iank/frogsboro/README.md

# frogsboro
FROGSBORO SAM9X60 board

Assembled board
Layout
