iank/frogsboro/(list of files, cad)

Other CAD files:
exports/frogsboro_v1.0.2/FROGSBORO.step
