iank/frogsboro/exports/frogsboro_v1.0.2/frogsboro_bom_v1.0.2.pdf

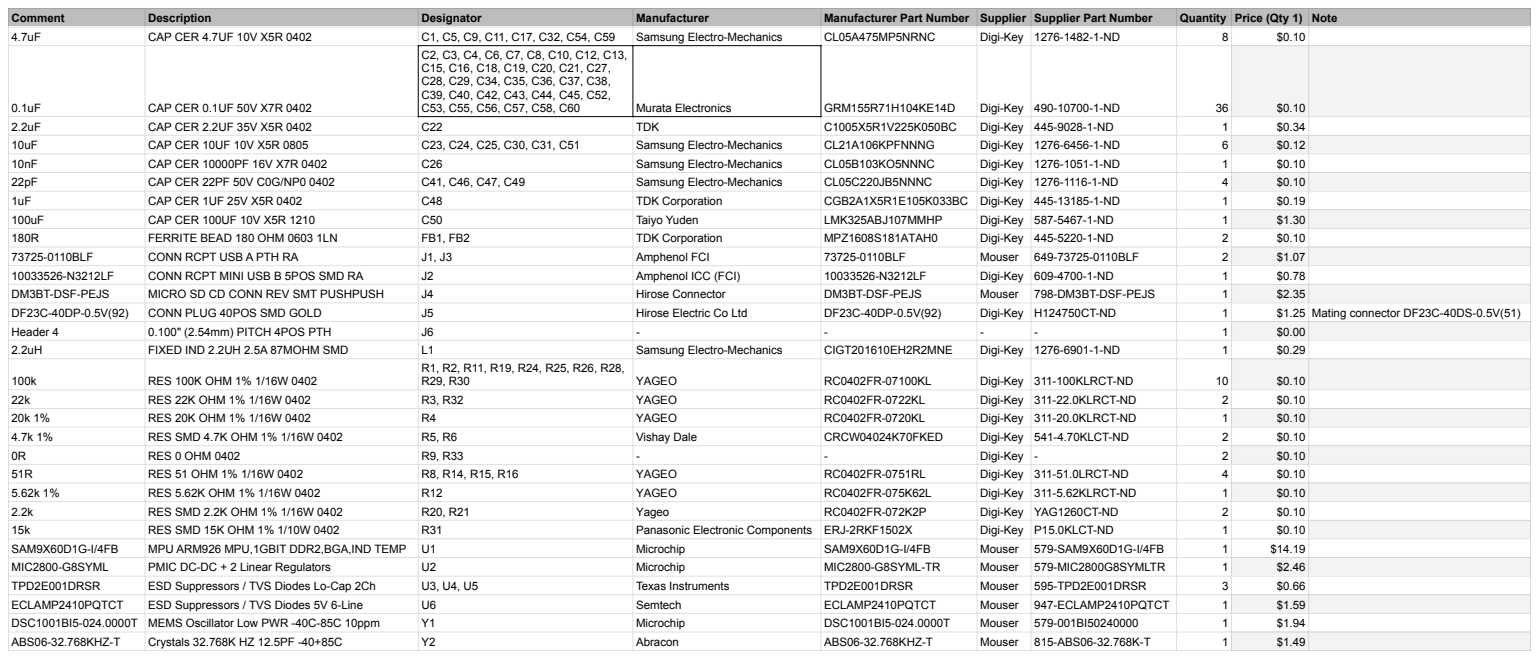
[picture p1: page 1]
