iank/frogsboro/exports/frogsboro_v1.0.2/frogsboro_schematic_v1.0.2.pdf

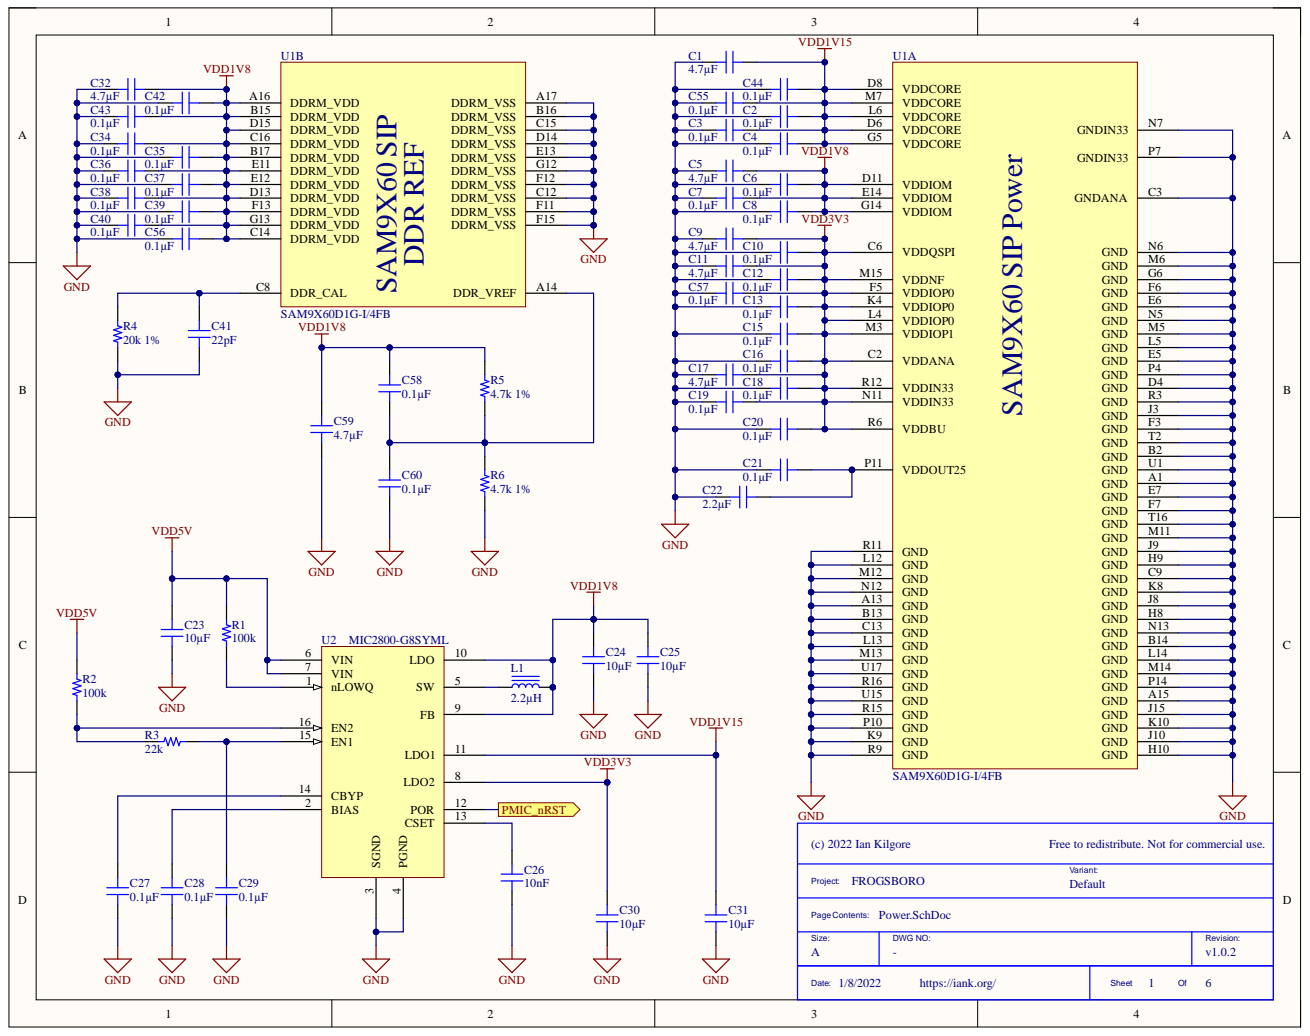
[picture p2: page 1]

4. 7 | µ F | C10
C1 1 | 0. 1 | µ F | M15 | M 6

C57 | 0. 1 | µ F | F 5 | F 6
0. 1 µ F | C13 | | K 4 | E 6

C19 | 0. 1 µ F
0. 1 | | J 3

Si z e : A | DWG NO : - | Re v i s i o n : v1.0.

Date : 1/8/2022 ht tps : //i ank.org/ | Sh e e t O f

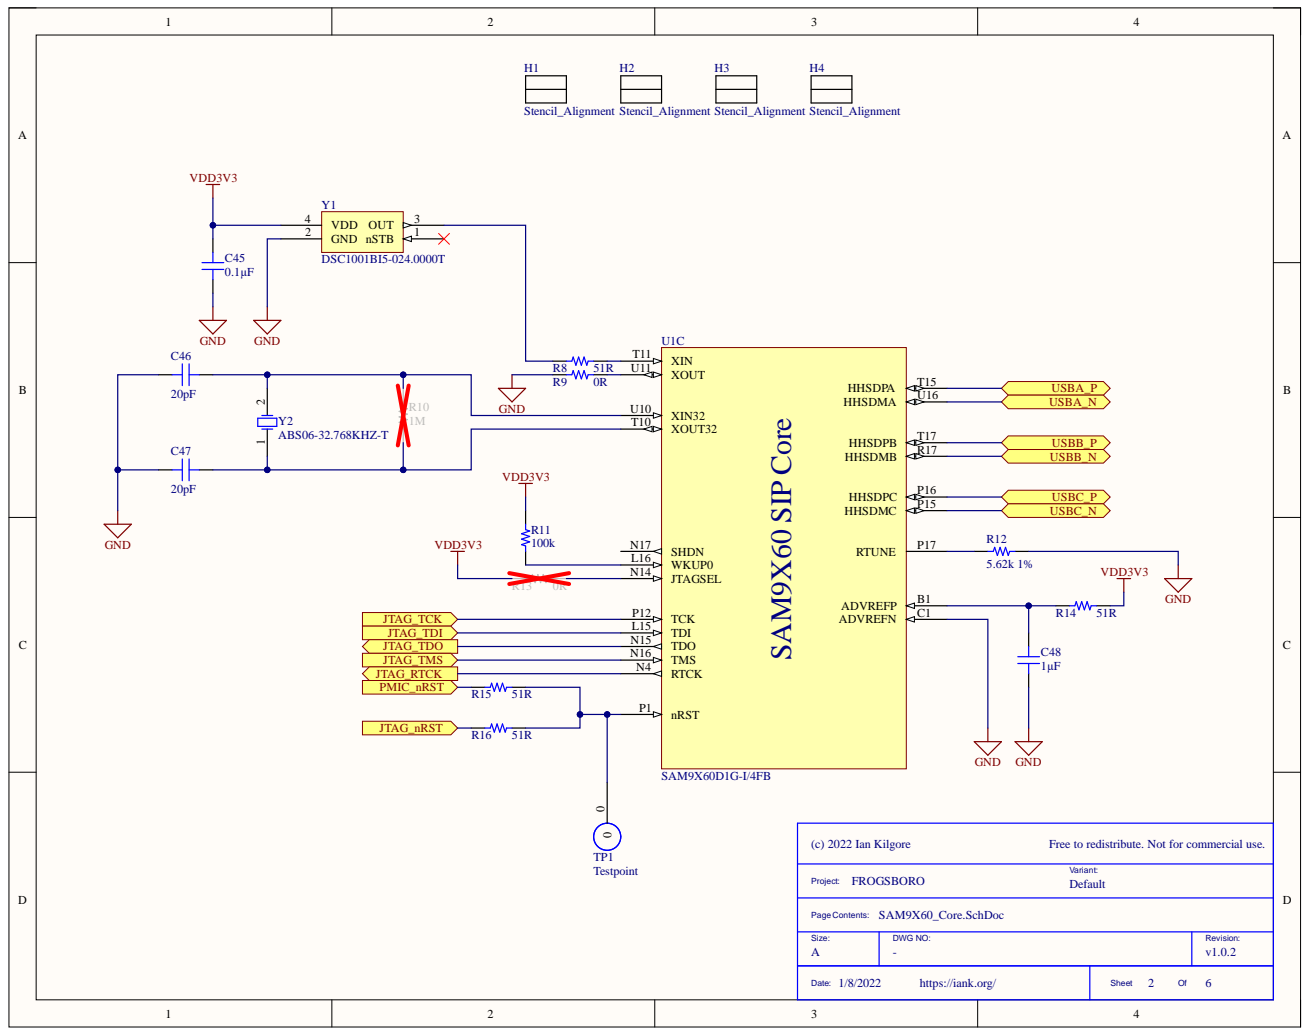
[picture p3: page 2]

Free to redistribute. Not for commercial use.

Size: A | DWG NO: - | Revision: v1.0.2

Date: 1/8/2022 https://iank.org/ | Sheet 2 Of 6

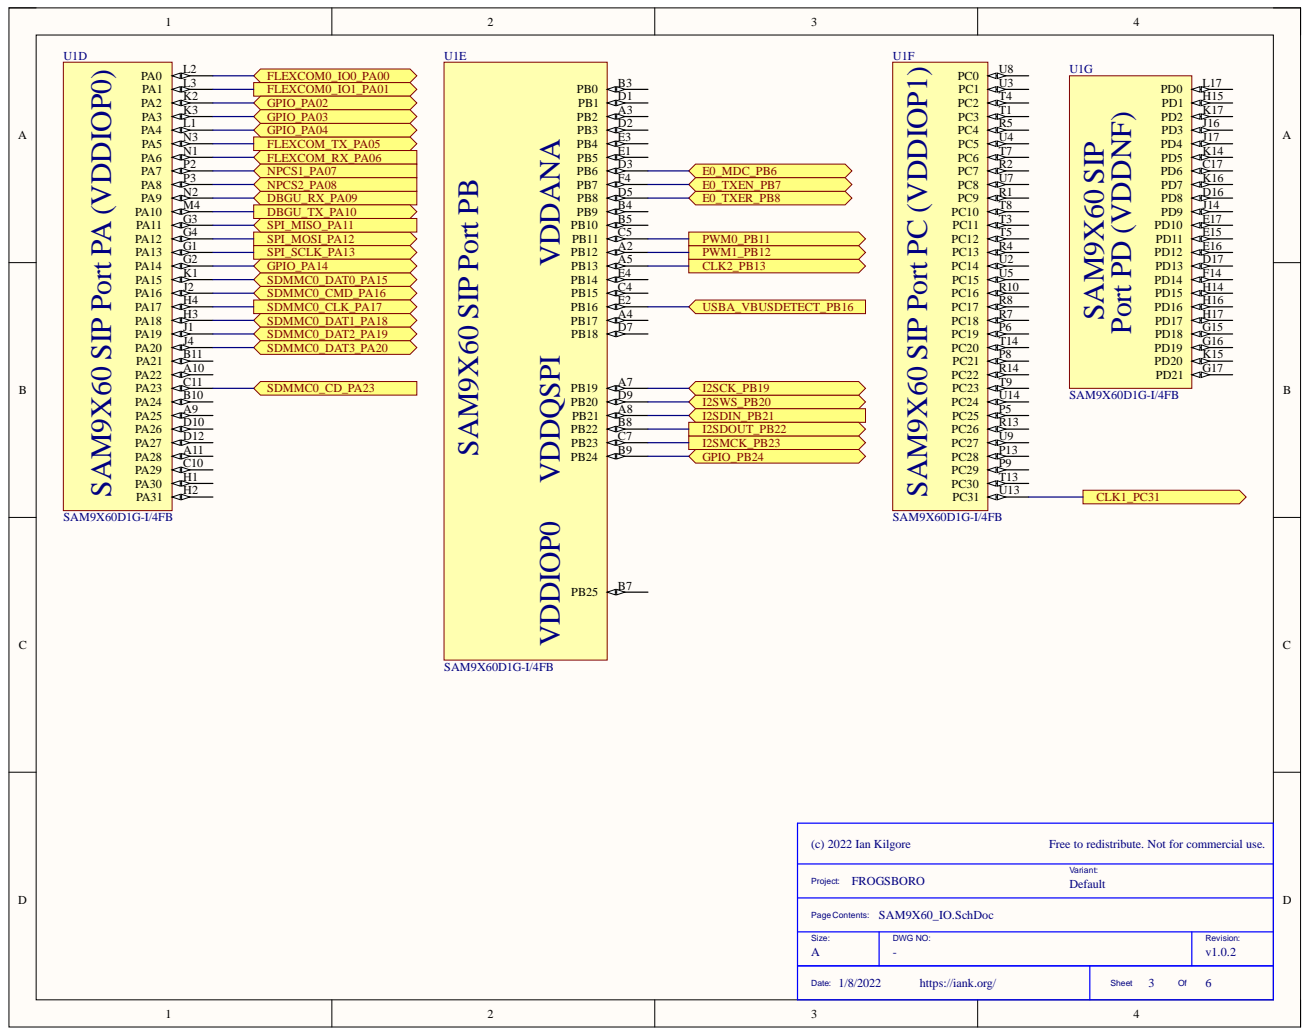
[picture p4: page 3]

Free to redistribute. Not for commercial use.

Size: | DWG NO: | Revision:

Date: 1/8/2022 https://iank.org/ | Sheet 3 Of 6

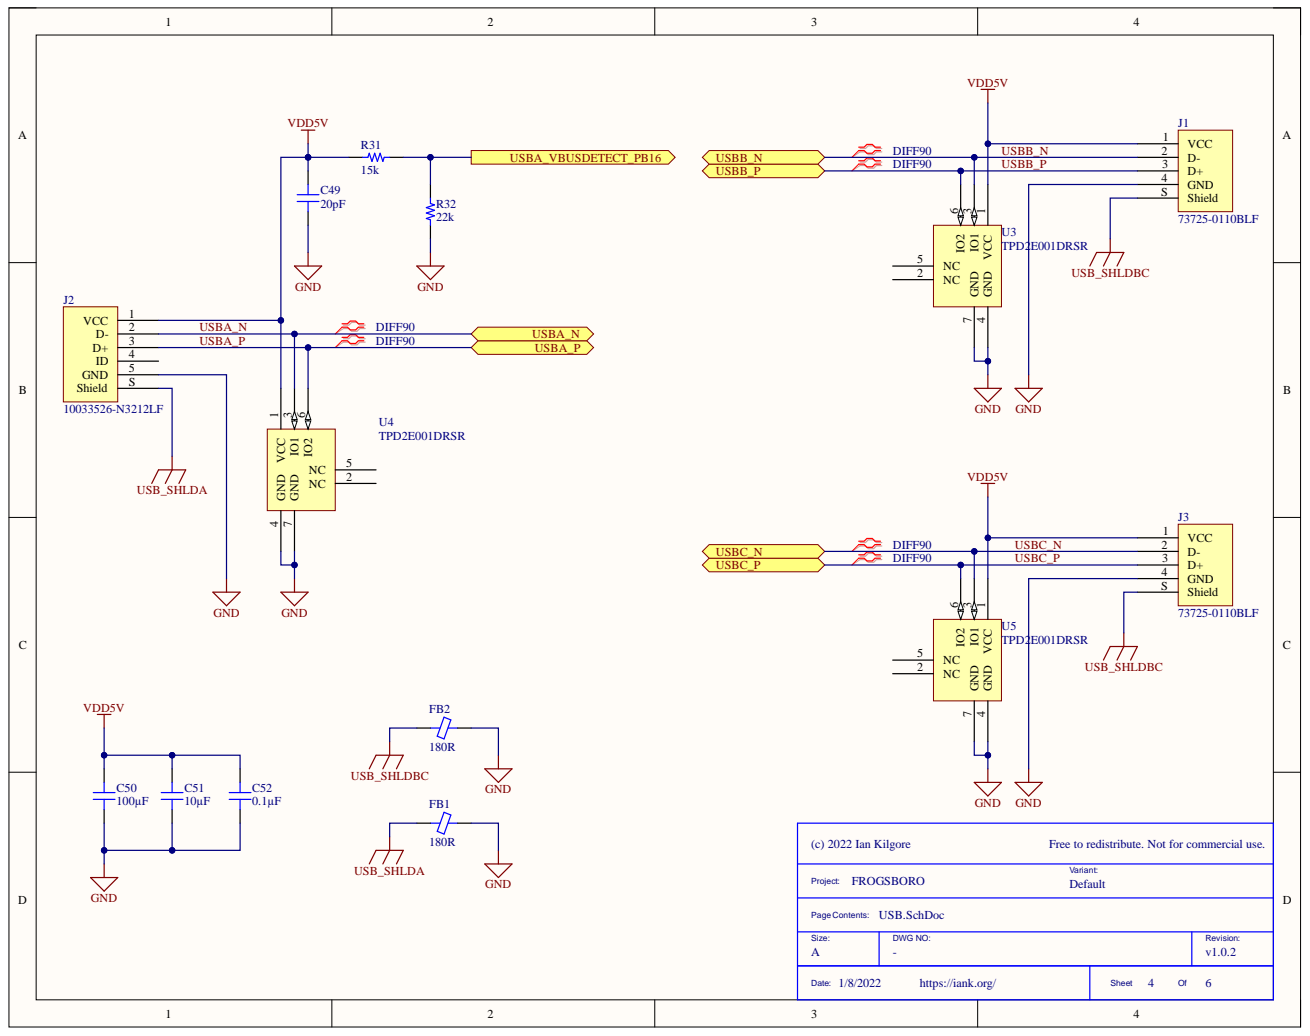
[picture p5: page 4]

Free to redistribute. Not for commercial use.

Page Contents: USB.SchDoc

Size: | DWG NO: | Revision:

Date: 1/8/2022 https://iank.org/ | Sheet 4 Of 6

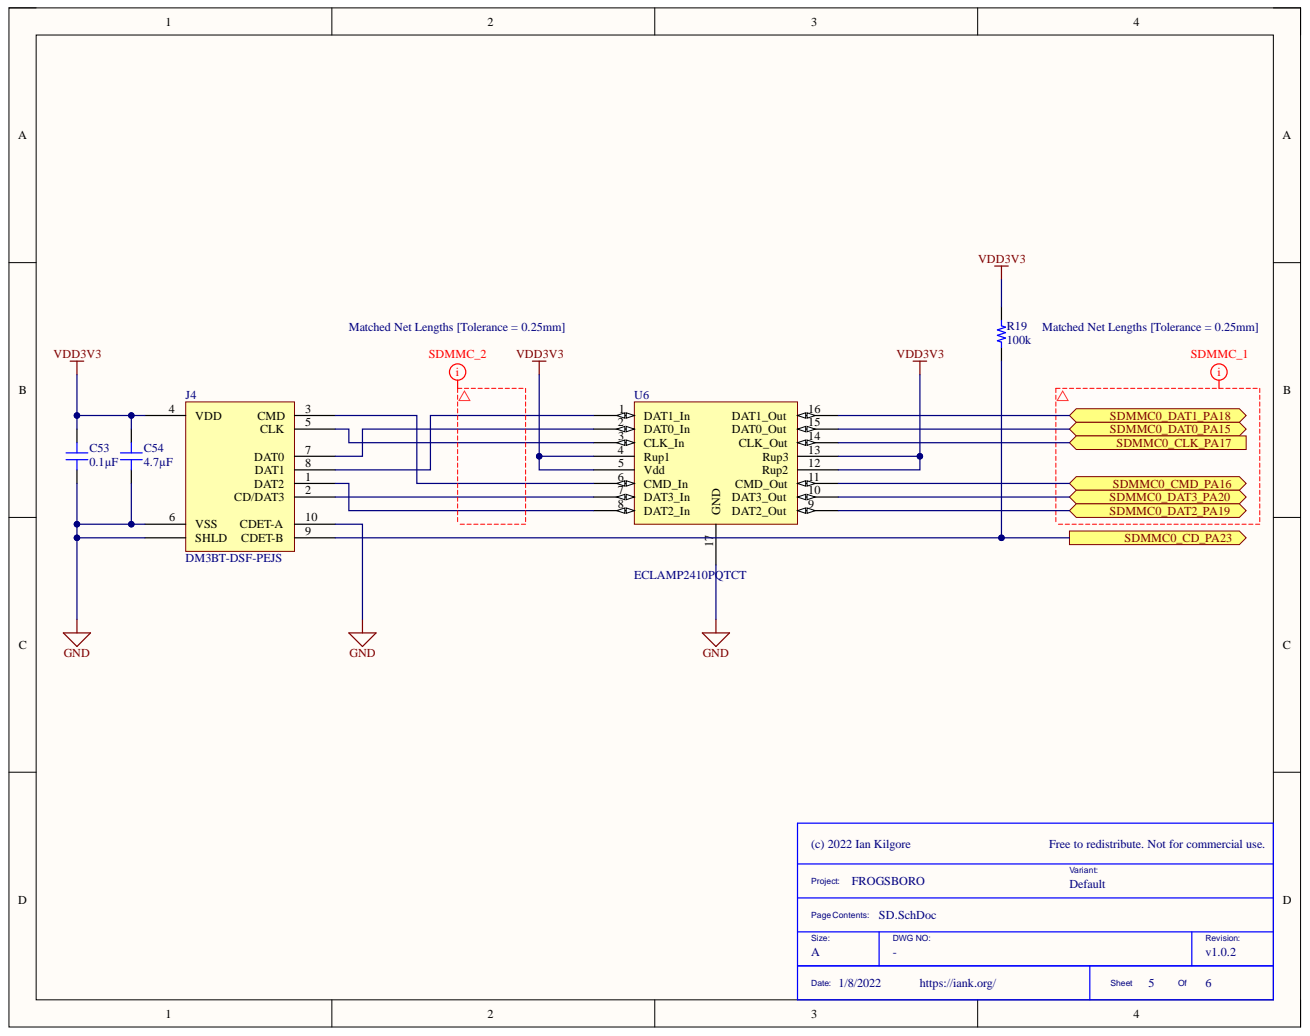
[picture p6: page 5]

Si z e : A | DWG NO : - | Re v i s i o n : v1.0.

Date : 1/8/2022 ht tps : //i ank.org/ | Sh e e t O f

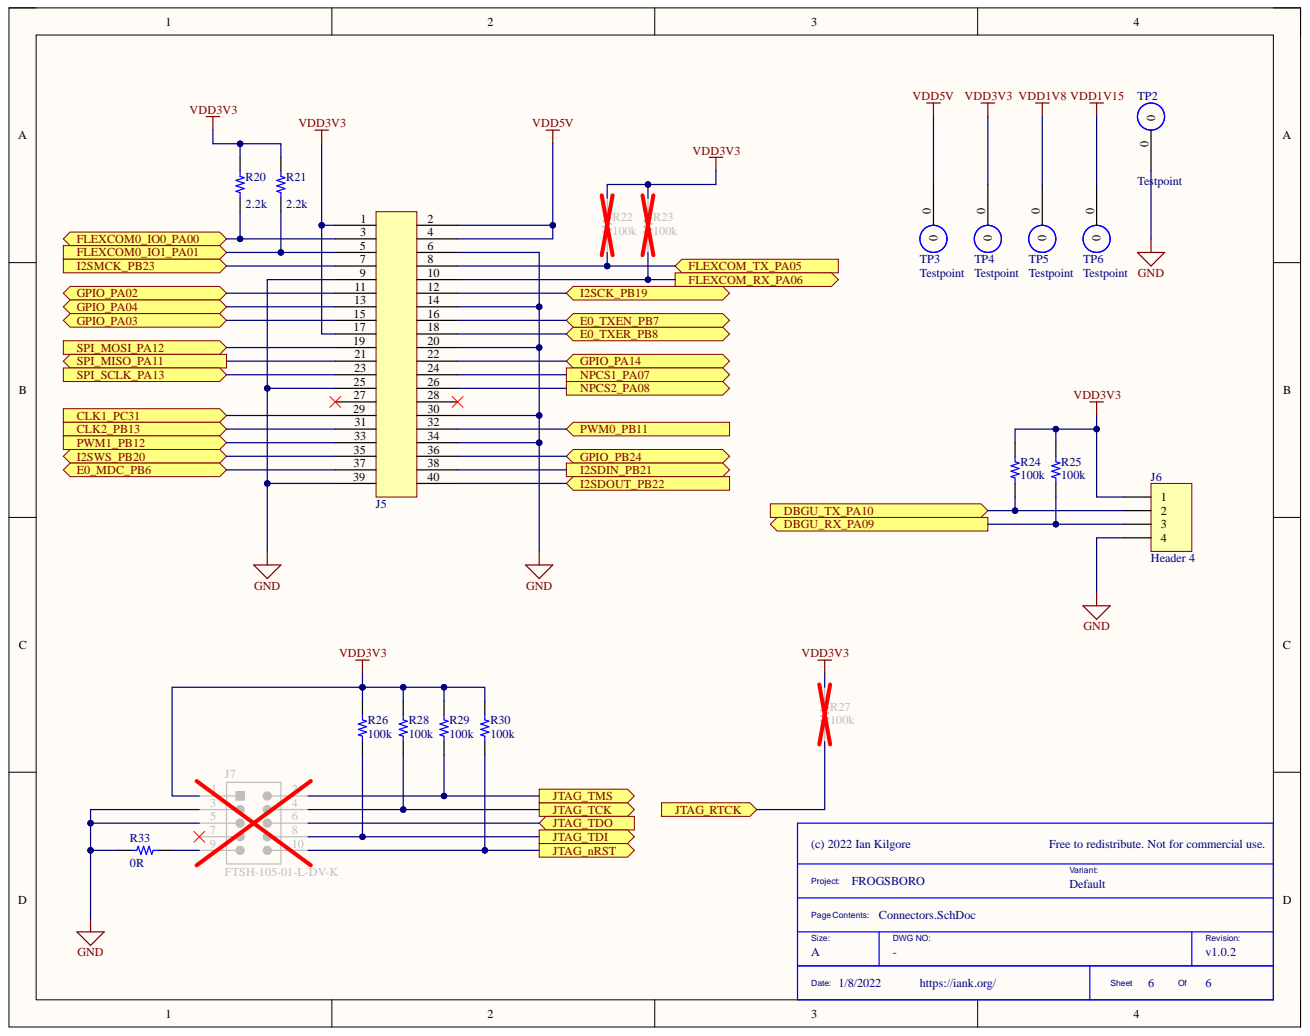
[picture p7: page 6]

7 | | 8 10 12 14
11
13

21 | 22 24 26 28
23
25
27
29 | 30
31 | 32 34
33

Free to redistribute. Not for commercial use.

Page Contents: Connectors.SchDoc

Size: | DWG NO: | Revision:

Date: 1/8/2022 https://iank.org/ | Sheet 6 Of 6

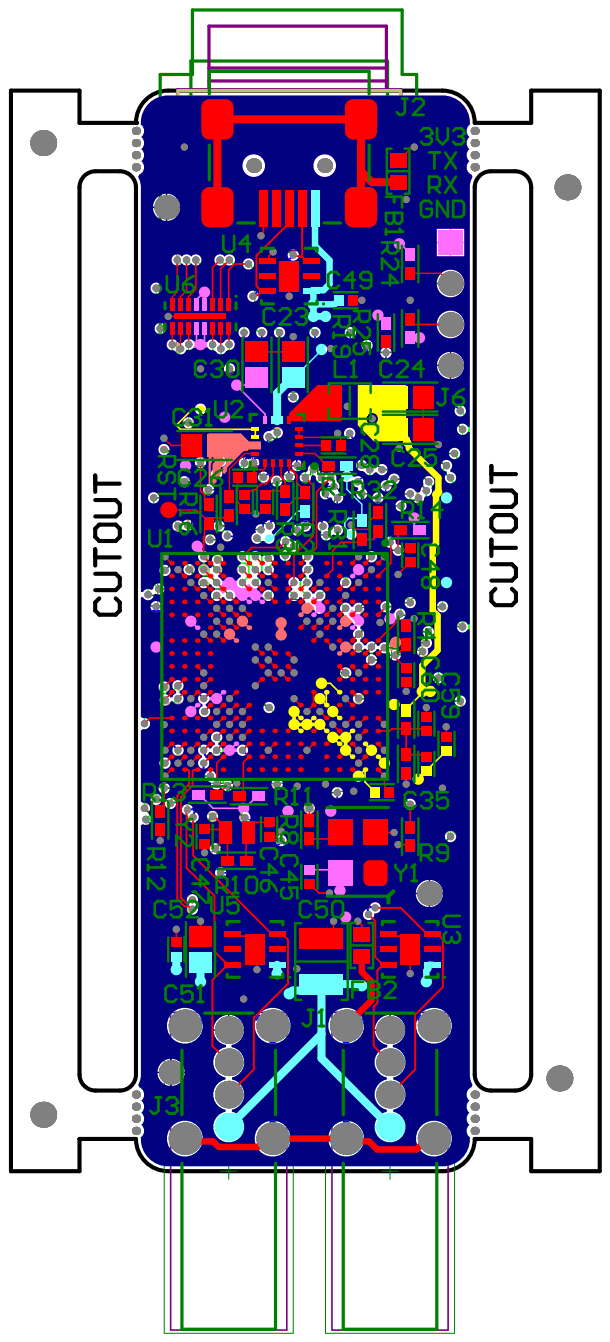
[picture p8: page 7]
