iank/frogsboro/(list of files, drawings)

Other design files:
FROGSBORO/Connectors.SchDoc
FROGSBORO/FROGSBORO.PcbDoc
FROGSBORO/FROGSBORO.PcbLib
FROGSBORO/FROGSBORO.PrjPcb
FROGSBORO/FROGSBORO.SchLib
FROGSBORO/Power.SchDoc
FROGSBORO/SAM9X60_Core.SchDoc
FROGSBORO/SAM9X60_IO.SchDoc
FROGSBORO/SD.SchDoc
FROGSBORO/USB.SchDoc
