iank/frogsboro/(commit log)

2022-01-12 Initial pass at schematic
    [Connectors.SchDoc, FROGSBORO.PcbDoc, FROGSBORO.PcbLib, FROGSBORO.PrjPcb, FROGSBORO.SchLib, Power.SchDoc, SAM9X60_Core.SchDoc, SAM9X60_IO.SchDoc]
2022-01-12 Fix DRAM voltage, annotate
    [Connectors.SchDoc, FROGSBORO.PrjPcb, FROGSBORO.SchLib, Power.SchDoc, SAM9X60_Core.SchDoc, SAM9X60_IO.SchDoc, SD.SchDoc, USB.SchDoc]
2022-01-12 BOM consolidation
    [FROGSBORO.PrjPcb, FROGSBORO.csv, Power.SchDoc, SAM9X60_Core.SchDoc, USB.SchDoc]
2022-01-12 Some final changes, footprints (not reviewed), annotation
    [Connectors.SchDoc, FROGSBORO.PcbLib, FROGSBORO.PrjPcb, FROGSBORO.SchLib, FROGSBORO.csv, Power.SchDoc, SAM9X60_Core.SchDoc, SAM9X60_IO.SchDoc]
2022-01-12 Removed DDR2 vref/vddram. First pass at outline, placement, and silkscreen.
    [Connectors.SchDoc, FROGSBORO.PcbDoc, FROGSBORO.PrjPcb, Power.SchDoc, USB.SchDoc]
2022-01-12 Updated SAM part/footprint
    [FROGSBORO.PcbDoc, FROGSBORO.PcbLib, FROGSBORO.PrjPcb, FROGSBORO.SchLib, Power.SchDoc, SAM9X60_Core.SchDoc, SAM9X60_IO.SchDoc]
2022-01-12 Routed I/O connector
    [FROGSBORO.PcbDoc, USB.SchDoc]
2022-01-12 Much routing, wow
    [FROGSBORO.PcbDoc, FROGSBORO.PrjPcb, Power.SchDoc]
2022-01-12 Finished routing
    [FROGSBORO.PcbDoc, FROGSBORO.PcbLib, FROGSBORO.PrjPcb, FROGSBORO.SchLib, Power.SchDoc]
2022-01-12 files sent to JLC, BOM
    [FROGSBORO.csv]
2022-01-12 Don't suppress pads on outer layers, fix a same-net pad/trace clearance. v1.0.1
    [FROGSBORO.GBL, FROGSBORO.GBO, FROGSBORO.GBP, FROGSBORO.GBS, FROGSBORO.GKO, FROGSBORO.GTL, FROGSBORO.GTO, FROGSBORO.GTP]
2022-01-12 v1.0.2:
    - Increased clearances to 0.105mm per JLC request
    - SD xSignals/length matching
    - Removed a mounting hole and made some silkscreen adjustments
    [FROGSBORO.GBL, FROGSBORO.GBO, FROGSBORO.GBP, FROGSBORO.GBS, FROGSBORO.GKO, FROGSBORO.GTL, FROGSBORO.GTO, FROGSBORO.GTP]
2022-01-12 Minor schematic cleanup
    [Connectors.SchDoc, FROGSBORO.PrjPcb, Power.SchDoc, SAM9X60_Core.SchDoc, SAM9X60_IO.SchDoc, SD.SchDoc, USB.SchDoc]
2022-01-12 Title block
    [Connectors.SchDoc, FROGSBORO.PrjPcb, FROGSBORO.SchLib, Power.SchDoc, SAM9X60_Core.SchDoc, SAM9X60_IO.SchDoc, SD.SchDoc, USB.SchDoc]
2022-01-12 Schematic and BOM PDFs
2022-01-12 Add 3d model for expansion connector and oscillator
    [FROGSBORO.PcbDoc, FROGSBORO.PcbLib]
2022-01-12 Add 3D model
    [FROGSBORO.step]
2022-01-12 v1.0.2 exports
    [FROGSBORO.GBL, FROGSBORO.GBO, FROGSBORO.GBP, FROGSBORO.GBS, FROGSBORO.GKO, FROGSBORO.GTL, FROGSBORO.GTO, FROGSBORO.GTP]
2022-11-11 Update link to board image
